Danya0x07/DxMicroMouse/src/speedctl.c

#include "speedctl.h"
#include "mcu.h"
#include "sensors.h"
#include "motors.h"
#include "encoders.h"
#include "imu.h"
#include "regulator.h"
#include "odometry.h"

#include <stdlib.h>
#include <string.h>
#include <stdio.h>

static FunctionalState state = DISABLE;
static SpeedCtlMode mode = SpeedCtlMode_STRAIGHT;

static int32_t targetVTransInTpS, targetVTransInt, vTransInTpS, vTransInt;
static int32_t targetVRotInLsbs, targetVRotInt, vRotInLsbs, vRotInt;

static struct Regulator vTransRegulator, vRotRegulator;

static struct {
    int32_t vTransKp, vTransKi, vTransKd;
    int32_t vRotKp, vRotKi, vRotKd;
    int32_t coeffSensors, coeffTrim, coeffDiag;
    int32_t minOutputThreshold, motorFeedForward;
} params = {
    .vTransKp = 1, .vTransKi = 0, .vTransKd = 40,
    .vRotKp = 5, .vRotKi = 0, .vRotKd = 20,
    .coeffSensors = 6, .coeffTrim = 40, .coeffDiag = 70,
    .minOutputThreshold = 0, .motorFeedForward = 0
};

static enum TelemetryMode {
    TelemetryMode_VTRANS,
    TelemetryMode_VROT
} telemetryMode;

void SpeedCtl_Reset(void)
{
    vTransInTpS = vRotInLsbs = 0;
    vTransInt = vRotInt = targetVTransInt = targetVRotInt = 0;
    Regulator_Reset(&vTransRegulator);
    Regulator_Reset(&vRotRegulator);
    Encoders_Reset();
}

void SpeedCtl_SetState(FunctionalState newState)
{
    state = newState;
    if (state == DISABLE) {
        SpeedCtl_SetTarget(0, 0);
        Motors_SetPwm(0, 0);
    }
}

FunctionalState SpeedCtl_GetState(void)
{
    return state;
}

void SpeedCtl_SetMode(SpeedCtlMode newMode)
{
    mode = newMode;
}

void SpeedCtl_Setup(void)
{
    SpeedCtl_Reset();
    Regulator_Setup(&vTransRegulator, params.vTransKp, params.vTransKi, params.vTransKd);
    Regulator_Setup(&vRotRegulator, params.vRotKp, params.vRotKi, params.vRotKd);
}

void SpeedCtl_SetTarget(int32_t vTransInMmPerS, int32_t vRotInDegPerS)
{
    targetVTransInTpS = vTransInMmPerS * COUNTS_PER_CELL / 180;
    targetVRotInLsbs = (vRotInDegPerS << 15) / 2000;
}

void SpeedCtl_GetSpeed(int32_t *vTransInMmPerS, int32_t *vRotInDegPerS)
{
    *vTransInMmPerS = vTransInTpS * 180 / COUNTS_PER_CELL;
    *vRotInDegPerS = vRotInLsbs * 2000 / 32768;
}

static int32_t AdjustRegOutput(int32_t regOutput)
{
    int32_t sign = 1;

    if (regOutput < 0) {
        sign = -1;
        regOutput = -regOutput;
    }

    if (regOutput < params.minOutputThreshold)
        regOutput = 0;
    else
        regOutput += params.motorFeedForward;

    if (regOutput > MOTOR_PWM_MAX)
        regOutput = MOTOR_PWM_MAX;

    return sign * regOutput;
}

void SpeedCtl_Update(void)
{
    struct EncoderCounts deltaCounts;
    struct IMU_Data imuData;

    Encoders_GetDelta(&deltaCounts);
    IMU_GetData(&imuData);

    int32_t transInCounts = (deltaCounts.left + deltaCounts.right) / 2;
    int32_t rotInCounts = deltaCounts.right - deltaCounts.left;

    // IMU LSBs = ImuUnits/S = mImuUnits/ms

    // mImuUnits/ms ~ m/(s^2) = (m/s)/s = (mm/s)/ms
    vTransInTpS = transInCounts * 1000;

    // Override gyro for backward trim movement
    int32_t coeffGyro = mode == SpeedCtlMode_BACKTRIM ? 100 : 1000;

    vRotInLsbs = (coeffGyro * imuData.gyroZ
            + (1000 - coeffGyro) * rotInCounts * 256) / 100;
    vRotInLsbs += vRotInLsbs > 0 ? 5 : -5;
    vRotInLsbs /= 10;

    // mImuUnits/ms ~ Deg/S = mDeg/ms
    Odometry_UpdateReckon(transInCounts, vRotInLsbs);

    if (mode == SpeedCtlMode_STRAIGHT && targetVTransInTpS > 0) {
        vRotInLsbs += params.coeffSensors * Sensors_GetStraightDeviation();
        if (Sensors_DetectTransition()) {
            Odometry_SnapReckon();
        }
    }
    else if (mode == SpeedCtlMode_DIAGONAL) {
        vRotInLsbs += params.coeffDiag * Sensors_GetDiagonalDeviation();
    }

    int32_t transOutput;
    int32_t rotOutput;

    if (mode != SpeedCtlMode_FRONTTRIM) {
        targetVTransInt += targetVTransInTpS;
        vTransInt += vTransInTpS;
        targetVRotInt += targetVRotInLsbs;
        vRotInt += vRotInLsbs;

        transOutput = Regulator_Output(&vTransRegulator, targetVTransInt, vTransInt) * MOTOR_PWM_MAX / 1000000;
        rotOutput = Regulator_Output(&vRotRegulator, targetVRotInt, vRotInt) * MOTOR_PWM_MAX / 1000000;
    }
    else {
        Sensors_GetTrimmingErrors(&transOutput, &rotOutput);
        transOutput *= params.coeffTrim;
        rotOutput *= params.coeffTrim;
    }

    int32_t leftOutput = transOutput - rotOutput;
    int32_t rightOutput = transOutput + rotOutput;

    leftOutput = AdjustRegOutput(leftOutput);
    rightOutput = AdjustRegOutput(rightOutput);

    if (state == ENABLE)
        Motors_SetPwm(leftOutput, rightOutput);
}

static int execute(int argc, char *argv[])
{
    if (argc < 1)
        return -1;

    if (!strcmp(argv[0], "sett")) {
        if (argc != 4)
            return -1;
        params.vTransKp = atol(argv[1]);
        params.vTransKi = atol(argv[2]);
        params.vTransKd = atol(argv[3]);
        SpeedCtl_Setup();
    }
    else if (!strcmp(argv[0], "setr")) {
        if (argc != 4)
            return -1;
        params.vRotKp = atol(argv[1]);
        params.vRotKi = atol(argv[2]);
        params.vRotKd = atol(argv[3]);
        SpeedCtl_Setup();
    }
    else if (!strcmp(argv[0], "th")) {
        if (argc != 3)
            return -1;
        params.minOutputThreshold = atoi(argv[1]);
        params.motorFeedForward = atoi(argv[2]);
    }
    else if (!strcmp(argv[0], "tgt")) {
        if (argc != 3)
            return -1;
        int32_t vTransInMmPerS = atoi(argv[1]);
        int32_t vRotInDegPerS = atoi(argv[2]);
        SpeedCtl_Reset();
        SpeedCtl_SetTarget(vTransInMmPerS, vRotInDegPerS);
    }
    else if (!strcmp(argv[0], "mode")) {
        if (argc != 2)
            return -1;

        unsigned mode = atoi(argv[1]);
        if (mode > SpeedCtlMode_FRONTTRIM)
            return -2;

        SpeedCtl_SetMode((SpeedCtlMode)mode);
    }
    else if (!strcmp(argv[0], "state")) {
        if (argc != 2)
            return -1;

        FunctionalState newState = (FunctionalState)!!atoi(argv[1]);
        SpeedCtl_SetState(newState);
    }
    else if (!strcmp(argv[0], "sens")) {
        if (argc != 2)
            return -1;
        params.coeffSensors = atoi(argv[1]);
    }
    else if (!strcmp(argv[0], "trim")) {
        if (argc != 2)
            return -1;
        params.coeffTrim = atoi(argv[1]);
    }
    else if (!strcmp(argv[0], "diag")) {
        if (argc != 2)
            return -1;
        params.coeffDiag = atoi(argv[1]);
    }
    else if (!strcmp(argv[0], "tm") && argc == 2)
        telemetryMode = (enum TelemetryMode)atoi(argv[1]);
    else if (!strcmp(argv[0], "ps")) {
        printf("SpeedCtl settings:\n"
               "vTrans: %ld %ld %ld\n"
               "vRot: %ld %ld %ld\n"
               "minThresh: %ld\tmFF: %ld\n"
               "cS:%ld\ttrim:%ld\tdiag:%ld\n",
               params.vTransKp, params.vTransKi, params.vTransKd,
               params.vRotKp, params.vRotKi, params.vRotKd,
               params.minOutputThreshold, params.motorFeedForward,
               params.coeffSensors, params.coeffTrim, params.coeffDiag);
    }
    else if (!strcmp(argv[0], "rst"))
        SpeedCtl_Reset();
    else {
        return -2;
    }

    return 0;
}

static void PrintTelemetry(void)
{
    if (telemetryMode == TelemetryMode_VTRANS) {
        printf("tgtV: %ld\tv: %ld\n", targetVTransInTpS, vTransInTpS);
    }
    else {
        printf("tgtW: %ld\tw: %ld\n", targetVRotInLsbs, vRotInLsbs);
    }
}

struct SchedulerTask TASK_TmSpeedCtl = {
    .execute = PrintTelemetry,
    .period = 200
};

static void load(const uint8_t *buffer)
{
    memcpy(&params, buffer, sizeof(params));
}

static void save(uint8_t *buffer)
{
    memcpy(buffer, &params, sizeof(params));
}

const struct Settings SETT_SpeedCtl = {
    .dataSize = sizeof(params),
    .load = load,
    .save = save
};

const struct ShellCommand CMD_SpeedCtl = {
    .name = "spctl",
    .execute = execute
};
