Danya0x07/DxMicroMouse/include/battery.h

#ifndef _INC_BATTERY_H
#define _INC_BATTERY_H

#include <scheduler.h>

typedef enum {
    BatteryStatus_DEAD = 0,
    BatteryStatus_LOW,
    BatteryStatus_MEDIUM,
    BatteryStatus_HIGH,
    BatteryStatus_FULL
} BatteryStatus;

void Battery_Update(void);
BatteryStatus Battery_GetStatus(void);
const char *Battery_StatusToStr(BatteryStatus status);

extern struct SchedulerTask TASK_TmBattery;

#endif // _INC_BATTERY_H
