Danya0x07/DxMicroMouse/(commit log)

2024-10-06 Add MPU6500 driver
2024-10-06 Add IMU self-test and calibration
2024-10-12 Add fan module
2024-10-16 Add AS5048A driver and Encoders module
2024-10-17 Add help and motors module
2024-11-04 Improve sensor reading procedure and move to LiPo 2S
2024-11-04 Add battery measurement
2024-12-30 Convert encoders data to 12 bit
2024-12-30 Improve energy usage during debug, reconfigure front sensor
2025-01-05 Add speed controller and odometry
2025-01-06 Move PID regulator to separate c/h
2025-01-06 Remove float from odometry
2025-02-12 Adjust PI speed control with complementary filtered feedback
2025-03-03 Fix button bug
2025-03-03 Fix encoders
2025-03-05 Add sensors calibration
2025-03-05 Add rotation correction by wall sensors
    [main.c, sensors.c, speedctl.c]
2025-03-05 Add battery check
2025-03-05 Fix steering correction frrdback path
    [main.c, regulator.c, sensors.c, speedctl.c]
2025-03-08 Increase sensors range
2025-03-09 Achieve 400 mm/s search run
2025-03-09 Fix maze missing bug
    [router.c]
2025-03-10 Fix router goal setting
    [router.c]
2025-03-11 Implement odometry snapping
2025-03-13 Correct steering error calculation
    [sensors.c]
2025-07-19 Update motors codefor new hw configuration
2025-07-31 Fix math error in speed profile generation
    [profile.c, utils.h]
2025-08-17 Add consecutive turn correction routine
    [maneuver.c, maneuver.h, motion.c, router.c]
2025-08-17 Correct default sensor thresholds
    [router.c, sensors.c]
2025-08-17 Add spctl reset on backtrim
    [maneuver.c]
2025-08-19 Change regulator topology to I-PD
2025-09-18 Refactor drivers
2025-10-16 Fix queue memory corruption
    [floodfill.c, maneuver.c, motion.c, router.c]
2025-10-19 Add basic diagonal correction
    [router.c, sensors.c, sensors.h, speedctl.c, speedctl.h]
